RafaelDiasCampos/RoboticChess/Report/TCC II/Project.tex

%% Baseado no arquivo: 
%% abtex2-modelo-trabalho-academico.tex, v-1.9.6 laurocesar
%% by abnTeX2 group at http://www.abntex.net.br/ 
%% Adaptado para um modelo dssse TCC (Graduação)

% ------------------------------------------------------------------------
% ------------------------------------------------------------------------
% abnTeX2: Modelo de Trabalho Academico (tese de doutorado, dissertacao de
% mestrado e trabalhos monograficos em geral) em conformidade com 
% ABNT NBR 14724:2011: Informacao e documentacao - Trabalhos academicos -
% Apresentacao
% ------------------------------------------------------------------------
% ------------------------------------------------------------------------

\documentclass[
	% -- opções da classe memoir --
	12pt,				% tamanho da fonte
	openright,			% capítulos começam em pág ímpar (insere página vazia caso preciso)
	oneside,			% para impressão em recto e verso. Oposto a oneside
	a4paper,			% tamanho do papel. 
	% -- opções da classe abntex2 --
	%chapter=TITLE,		% títulos de capítulos convertidos em letras maiúsculas
	%section=TITLE,		% títulos de seções convertidos em letras maiúsculas
	%subsection=TITLE,	% títulos de subseções convertidos em letras maiúsculas
	%subsubsection=TITLE,% títulos de subsubseções convertidos em letras maiúsculas
	% -- opções do pacote babel --
	english,			% idioma adicional para hifenização
	%french,				% idioma adicional para hifenização
	%spanish,			% idioma adicional para hifenização
	brazil				% o último idioma é o principal do documento
	]{abntex2}

% ---
% Pacotes básicos 
% ---
\usepackage{lmodern}			% Usa a fonte Latin Modern			
\usepackage[T1]{fontenc}		% Selecao de codigos de fonte.
\usepackage[utf8]{inputenc}		% Codificacao do documento (conversão automática dos acentos)
\usepackage{lastpage}			% Usado pela Ficha catalográfica
\usepackage{indentfirst}		% Indenta o primeiro parágrafo de cada seção.
\usepackage{color}				% Controle das cores
\usepackage{graphicx}			% Inclusão de gráficos
\usepackage{microtype} 			% para melhorias de justificação
\usepackage{float}				% para controle de posicionamento de figuras e tabelas
\usepackage{pdfpages} 			% para inclusão de PDFs
\usepackage{breqn}              % para quebrar equações
% ---

% ---
% Pacotes de citações
% ---
\usepackage[brazilian,hyperpageref]{backref}	 % Paginas com as citações na bibl
\usepackage[alf, bibjustif]{abntex2cite}	% Citações padrão ABNT

% --- 
% CONFIGURAÇÕES DE PACOTES
% --- 

% ---
% Configurações do pacote backref
% Usado sem a opção hyperpageref de backref
\renewcommand{\backrefpagesname}{%Citado na(s) página(s):~
}
% Texto padrão antes do número das páginas
\renewcommand{\backref}{}
% Define os textos da citação
\renewcommand*{\backrefalt}[4]{
	%\ifcase #1 %
	%	Nenhuma citação no texto.%
	%\or
	%	Citado na página #2.%
	%\else
	%	Citado #1 vezes nas páginas #2.%
	%\fi
    }%
% ---

% ---
% Informações de dados para CAPA e FOLHA DE ROSTO
% ---
\titulo{Jogo de Xadrez com Manipuladores Robóticos}
\autor{Rafael Dias Campos}
\local{Belo Horizonte}
\data{2023}
\orientador{Ramon da Cunha Lopes}
\instituicao{%
  Centro Federal de Educação Tecnológica de Minas Gerais -- CEFET-MG
  \par
  Departamento de Computação
  \par
  Curso de Engenharia da Computação
  }
\tipotrabalho{Monografia (Graduação)}
% O preambulo deve conter o tipo do trabalho, o objetivo, 
% o nome da instituição e a área de concentração 
\preambulo{Trabalho de Conclusão de Curso apresentado ao Curso
de Engenharia de Computação do Centro Federal de
Educação Tecnológica de Minas Gerais, como requisito
parcial para a obtenção do título de Bacharel em
Engenharia de Computação.}
% ---

% ---
% Configurações de aparência do PDF final

% alterando o aspecto da cor azul
\definecolor{blue}{RGB}{41,5,195}

% informações do PDF
\makeatletter
\hypersetup{
     	%pagebackref=true,
		pdftitle={\@title}, 
		pdfauthor={\@author},
    	pdfsubject={\imprimirpreambulo},
	    pdfcreator={LaTeX with abnTeX2},
		pdfkeywords={abnt}{latex}{abntex}{abntex2}{trabalho acadêmico}, 
		colorlinks=true,       		% false: boxed links; true: colored links
		% hidelinks=true,
    	linkcolor=blue,          	% color of internal links
    	citecolor=blue,        		% color of links to bibliography
    	filecolor=magenta,      		% color of file links
		urlcolor=blue,
		bookmarksdepth=4
}
\makeatother
% --- 

% --- 
% Espaçamentos entre linhas e parágrafos 
% --- 

% O tamanho do parágrafo é dado por:
\setlength{\parindent}{1.3cm}

% Controle do espaçamento entre um parágrafo e outro:
\setlength{\parskip}{0.2cm}  % tente também \onelineskip

% ---
% compila o indice
% ---
\makeindex
% ---

% ----
% Início do documento
% ----
\begin{document}

% Seleciona o idioma do documento (conforme pacotes do babel)
%\selectlanguage{english}
%\selectlanguage{brazil}

% Retira espaço extra obsoleto entre as frases.
\frenchspacing 

% ----------------------------------------------------------
% ELEMENTOS PRÉ-TEXTUAIS
% ----------------------------------------------------------

\include{src/0_pre_textuais}

% ----------------------------------------------------------
% ELEMENTOS TEXTUAIS
% ----------------------------------------------------------
\textual

% ----------------------------------------------------------
% Como o documento será grande, sugiro dividir em diversos arquivos, um para cada capítulo.
% ----------------------------------------------------------

\include{src/1_introducao}

\include{src/2_trabalhos_relacionados}

\include{src/3_metodologia}

\include{src/4_planejamento}

\include{src/5_desenvolvimento}

\include{src/6_conclusao}

% ----------------------------------------------------------

% ----------------------------------------------------------
% Finaliza a parte no bookmark do PDF
% para que se inicie o bookmark na raiz
% e adiciona espaço de parte no Sumário
% ----------------------------------------------------------
\phantompart

% ----------------------------------------------------------
% ELEMENTOS PÓS-TEXTUAIS
% ----------------------------------------------------------

\include{src/pos_textuais.tex}

\end{document}
