RafaelDiasCampos/RoboticChess/Report/TCC I/src/0_pre_textuais.tex

%% Baseado no arquivo: 
%% abtex2-modelo-trabalho-academico.tex, v-1.9.6 laurocesar
%% by abnTeX2 group at http://www.abntex.net.br/ 
%% Adaptado para um modelo de TCC (Graduação)

% ---
% Capa
% ---
\imprimircapa
% ---

% ---
% Folha de rosto
% (o * indica que haverá a ficha bibliográfica)
% ---
\imprimirfolhaderosto*
% ---

% ---
% Inserir a ficha bibliografica
% ---

% Isto é um exemplo de Ficha Catalográfica, ou ``Dados internacionais de
% catalogação-na-publicação''. Você pode utilizar este modelo como referência. 
% Porém, provavelmente a biblioteca da sua universidade lhe fornecerá um PDF
% com a ficha catalográfica definitiva após a defesa do trabalho. Quando estiver
% com o documento, salve-o como PDF no diretório do seu projeto e substitua todo
% o conteúdo de implementação deste arquivo pelo comando abaixo:
%
% \begin{fichacatalografica}
%     
% \end{fichacatalografica}

\begin{fichacatalografica}
~
%\includepdf{fig_ficha_catalografica.pdf}
% 	\sffamily
% 	\vspace*{\fill}					% Posição vertical
% 	\begin{center}					% Minipage Centralizado
% 	\fbox{\begin{minipage}[c][8cm]{13.5cm}		% Largura
% 	\small
% 	\imprimirautor
% 	%Sobrenome, Nome do autor
	
% 	\hspace{0.5cm} \imprimirtitulo  / \imprimirautor. --
% 	\imprimirlocal, \imprimirdata-
	
% 	\hspace{0.5cm} \pageref{LastPage} p. : il. (algumas color.) ; 30 cm.\\
	
% 	\hspace{0.5cm} \imprimirorientadorRotulo~\imprimirorientador\\
	
% 	\hspace{0.5cm}
% 	\parbox[t]{\textwidth}{\imprimirtipotrabalho~--~\imprimirinstituicao,
% 	\imprimirdata.}\\
	
% 	\hspace{0.5cm}
% 		1. Palavra-chave1.
% 		2. Palavra-chave2.
% 		2. Palavra-chave3.
% 		I. Orientador.
% 		II. Universidade xxx.
% 		III. Faculdade de xxx.
% 		IV. Título 			
% 	\end{minipage}}
% 	\end{center}
\end{fichacatalografica}
% ---

% % ---
% % Inserir errata
% % ---
% \begin{errata}
% Elemento opcional da \citeonline[4.2.1.2]{NBR14724:2011}. Exemplo:

% \vspace{\onelineskip}

% FERRIGNO, C. R. A. \textbf{Tratamento de neoplasias ósseas apendiculares com
% reimplantação de enxerto ósseo autólogo autoclavado associado ao plasma
% rico em plaquetas}: estudo crítico na cirurgia de preservação de membro em
% cães. 2011. 128 f. Tese (Livre-Docência) - Faculdade de Medicina Veterinária e
% Zootecnia, Universidade de São Paulo, São Paulo, 2011.

% \begin{table}[htb]
% \center
% \footnotesize
% \begin{tabular}{|p{1.4cm}|p{1cm}|p{3cm}|p{3cm}|}
%   \hline
%    \textbf{Folha} & \textbf{Linha}  & \textbf{Onde se lê}  & \textbf{Leia-se}  \\
%     \hline
%     1 & 10 & auto-conclavo & autoconclavo\\
%    \hline
% \end{tabular}
% \end{table}

% \end{errata}
% ---

% ---
% Inserir folha de aprovação
% ---

%
% \begin{folhadeaprovacao}

%   \begin{center}
%     Espaço destinado à folha de aprovação
% %após aprovação, insira a cópia da folha de aprovação por meio do comando:
% % \includepdf{folhadeaprovacao_final.pdf}
%   \end{center}
  
% \end{folhadeaprovacao}
% ---

% ---
% Dedicatória
% ---
% \begin{dedicatoria}
%    \vspace*{\fill}
%    \centering
%    \noindent
%    \textit{Dedico este trabalho aos alunos(as) do CEFET-MG.} \vspace*{\fill}
% \end{dedicatoria}
% ---

% ---
% Agradecimentos
% ---
% \begin{agradecimentos}
% Agradeço ao Latex e às pessoas que contribuiram com o desenvolvimento do Abntex2 por facilitarem a vida dos graduandos.
% \end{agradecimentos}
% ---

% ---
% Epígrafe
% ---
% \begin{epigrafe}
%     \vspace*{\fill}
% 	\begin{flushright}
% 		\textit{``As pessoas costumam dizer que a motivação não dura sempre. Bem, nem o efeito do banho, por isso recomenda-se diariamente.''\\
% 		(Zig Ziglar)}
% 	\end{flushright}
% \end{epigrafe}
% ---

% ---
% RESUMOS
% ---

% resumo em português
\setlength{\absparsep}{18pt} % ajusta o espaçamento dos parágrafos do resumo
\begin{resumo}
  Atualmente, existe uma grande procura por funcionários especializados em Tecnologia da Informação (TI) e áreas similares, sendo percebida no mundo todo uma carência de profissionais qualificados para atuar nessas áreas.
  Esse problema ocorre parcialmente devido a um desinteresse à capacitação técnica por parte de crianças e jovens, frequentemente devido a uma concepção de que essas áreas são difíceis e/ou desinteressantes.
  Com o foco neste aspecto, esse projeto visa desenvolver um sistema que possibilita o jogo de Xadrez entre duas pessoas por meio de manipuladores robóticos.
  Este sistema pode ser apresentado para crianças e jovens em feiras educativas e eventos similares com o objetivo de introduzir conceitos básicos e instigar o interesse pelas áreas de computação, elétrica e controle.
  Sistemas já existentes para mover peças de xadrez com braços mecânicos normalmente são utilizados para que uma máquina jogue contra um jogador humano em campeonatos e com isso apresentam alto custo monetário, visto que priorizam velocidade e precisão nos movimentos.
  Por isso, eles não são muito adequados para usos educacionais e têm-se a necessidade de desenvolver um sistema mais barato e com foco na simplicidade e na capacidade de proporcionar divertimento para os jogadores.
  Nesse projeto serão utilizados manipuladores robóticos comerciais já adquiridos pela instituição de ensino.
  Para o controle dos manipuladores, serão utilizados dois \textit{joysticks}, um para cada jogador, que enviam sinais para uma placa de controle dos manipuladores por meio de um microcontrolador.
  Até o momento, foi desenvolvida uma placa de controle para enviar os sinais para os manipuladores robóticos, e um \textit{software} para realizar a leitura dos \textit{joysticks} e enviar os sinais para a placa de controle.
  Ainda está em desenvolvimento o \textit{software} que implementará a lógica do jogo de Xadrez, e o controle do segundo manipulador.
 \textbf{Palavras-chave}: Manipuladores Robóticos. Controle Digital. Xadrez.
\end{resumo}

% resumo em inglês
\begin{resumo}[Abstract]
 \begin{otherlanguage*}{english}
  Currently, there is a great demand for specialized professionals in IT and in similar areas, and it is perceived worldwide a shortage of qualified professionals to work in these areas.
  This problem occurs partially due to a lack of technical training on the part of children and young people, often due to a conception that these areas are difficult and / or uninteresting.
  Focusing on this aspect, this project aims to develop a system that allows the game of Chess between two people through robotic manipulators.
  This system can be presented to children and young people in educational fairs and similar events with the aim of introducing basic concepts and instigating interest in the areas of computing, electrical and control.
  Systems already exist to move chess pieces with mechanical arms usually used to allow a machine to play against a human player in tournaments and with that they present high monetary cost, for they prioritize speed and precision in movements.
  Therefore, they are not very suitable for educational uses and there is a need to develop a cheaper system and with a focus on simplicity and the ability to provide fun for players.
  In this project will be used commercial robotic manipulators already acquired by the educational institution.
  For the control of the manipulators, two joysticks will be used, one for each player, which send signals to a control board through a microcontroller.
  So far, a control board has been developed to send signals to the robotic manipulators and a software to read the joysticks and send signals to the control board.
  The software that implements the logic of the Chess game is still under development, as well as the control of the second manipulator.

   \vspace{\onelineskip}
 
   \noindent 
   \textbf{Keywords}: Robotic Arms. Digital Control. Chess.
 \end{otherlanguage*}
\end{resumo}

% ---

% ---
% inserir lista de ilustrações
% ---
\pdfbookmark[0]{\listfigurename}{lof}
\listoffigures*
\cleardoublepage
% ---

% ---
% inserir lista de tabelas
% ---
\pdfbookmark[0]{\listtablename}{lot}
\listoftables*
\cleardoublepage
% ---

% ---
% inserir lista de abreviaturas e siglas
% ---
\begin{siglas}
  \item[CI] Circuito Integrado
  \item[CEFET-MG] Centro Federal de Educação Tecnológica de Minas Gerais
  \item[STEM] \textit{Science, Technology, Engineering and Mathematics} [Ciência, Tecnologia, Engenharia e Matemática]
  \item[PID] \textit{Proportional Integral Derivative} [Proporcional Integral Derivativo]
  \item[PWM] \textit{Pulse Width Modulation} [Modulação de Largura de Pulso]  
\end{siglas}
% ---

% ---
% inserir lista de símbolos
% ---
% \begin{simbolos}
%   \item[$ \Gamma $] Letra grega Gama
%   \item[$ \Lambda $] Lambda
%   \item[$ \zeta $] Letra grega minúscula zeta
%   \item[$ \in $] Pertence
% \end{simbolos}
% ---

% ---
% inserir o sumario
% ---
\pdfbookmark[0]{\contentsname}{toc}
\tableofcontents*
\cleardoublepage
% ---
