RafaelDiasCampos/RoboticChess/Report/PreProject/src/pos_textuais_preproject.tex

%% Baseado no arquivo: 
%% abtex2-modelo-trabalho-academico.tex, v-1.9.6 laurocesar
%% by abnTeX2 group at http://www.abntex.net.br/ 
%% Adaptado para um modelo de TCC (Graduação)

\postextual
% ----------------------------------------------------------

% ----------------------------------------------------------
% Referências bibliográficas
% ----------------------------------------------------------
\bibliography{report}

% ----------------------------------------------------------
% Glossário
% ----------------------------------------------------------
%
% Consulte o manual da classe abntex2 para orientações sobre o glossário.
%
%\glossary
