RafaelDiasCampos/RoboticChess/Report/PreProject/src/2_metodologia.tex

\chapter[Metodologia]{Metodologia}
\label{cap:metodologia}

Para o desenvolvimento desse projeto, foi realizada a seguinte divisão em atividades:

\begin{itemize}
    \item \textbf{Análise do problema:} Análise do problema e definição de objetivos.
    \item \textbf{Pesquisa bibliográfica:} Pesquisa bibliográfica para a definição de tecnologias a serem utilizadas.
    \item \textbf{Projeto do sistema:} Projeto do sistema de controle de manipuladores robóticos e de microcontroladores utilizados.
    \item \textbf{Controle de um manipulador:} Controle de um manipulador robótico para realização de partidas de Xadrez entre um jogador humano e o computador.
    \item \textbf{Controle de dois manipuladores:} Controle de dois manipuladores robóticos para realização de partidas de Xadrez entre dois jogadores humanos.
    \item \textbf{Avaliação:} Avaliação do protótipo quanto a funcionalidade e ao cumprimento dos objetivos propostos.
\end{itemize}
