RafaelDiasCampos/RoboticChess/Report/PreProject/src/3_infraestrutura_necessaria.tex

\chapter[Infraestrutura Necessária]{Infraestrutura Necessária}
\label{cap:infraestrutura_necessaria}

Para o desenvolvimento desse projeto, foi definida a necessidade dos seguintes recursos:

\begin{itemize}
    \item \textbf{Manipuladores robóticos:} Capazes de realizar movimentos de rotação e translação, além de serem capazes de realizar movimentos de pinça para a captura de peças.
    \item \textbf{Placas de controle}: Necessárias para realizar o controle dos manipuladores robóticos por meio de microcontroladores.
    \item \textbf{Microcontroladores:} Utilizados para a comunicação com os manipuladores robóticos e com o computador.
    \item \textbf{Computador:} Realiza a comunicação com os microcontroladores.
    \item \textbf{Jogo de Xadrez:} Necessário para a realização de partidas de Xadrez.
\end{itemize}
