RafaelDiasCampos/RoboticChess/Report/TCC I/img/foto-arduino.png

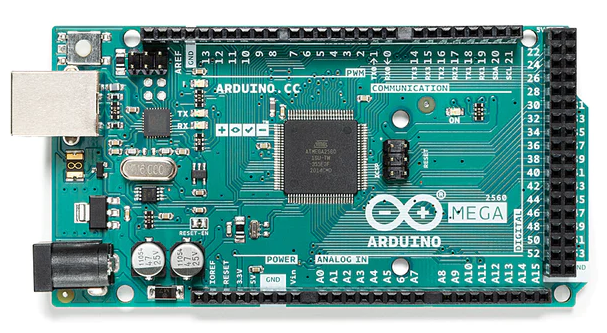
Report/TCC I/img/foto-arduino.png
