RafaelDiasCampos/RoboticChess/Report/TCC I/img/placa-controle-esquematico-simplificado.png

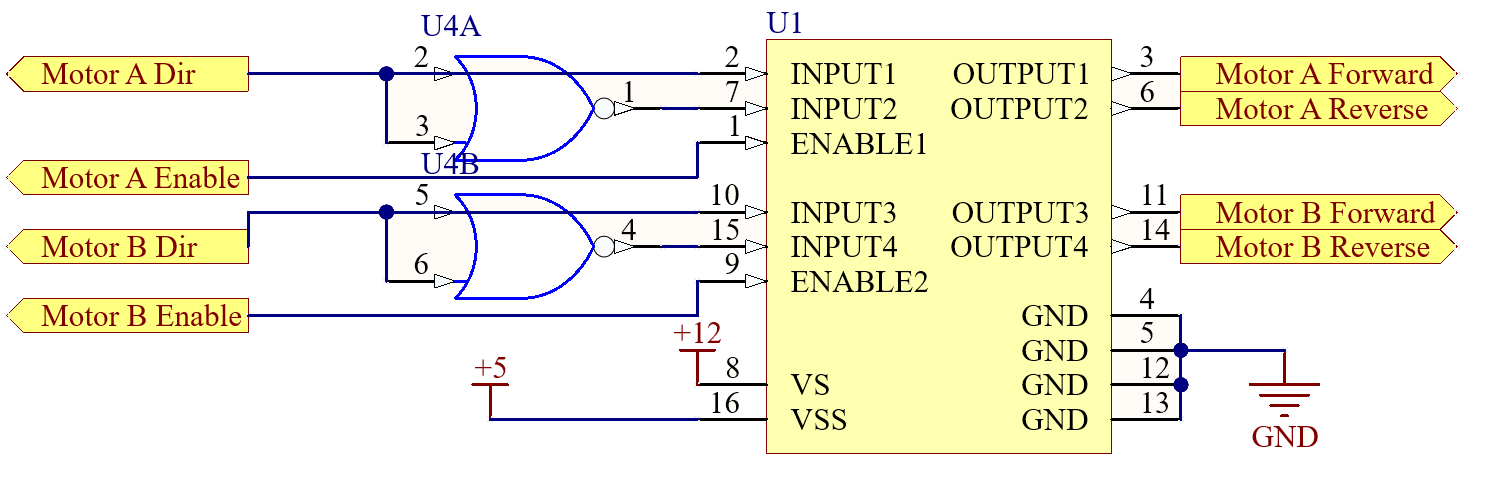
Report/TCC I/img/placa-controle-esquematico-simplificado.png
