RafaelDiasCampos/RoboticChess/Report/TCC I/img/placa-controle-layout.png

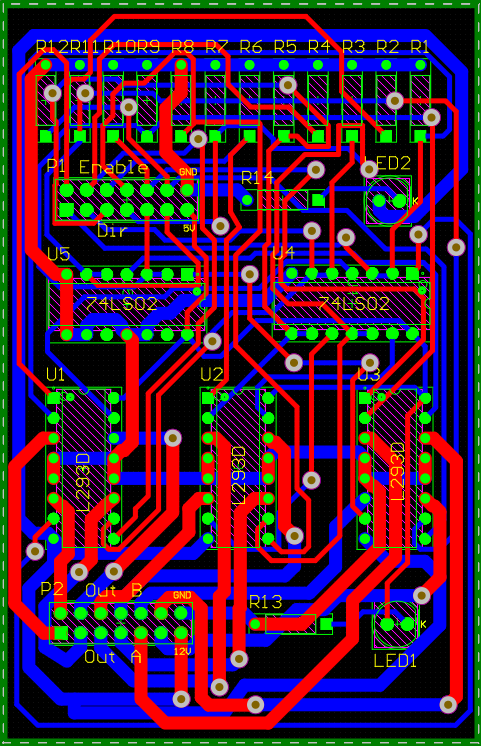
Report/TCC I/img/placa-controle-layout.png
