RafaelDiasCampos/RoboticChess/Report/TCC I/img/projeto-sistema.png

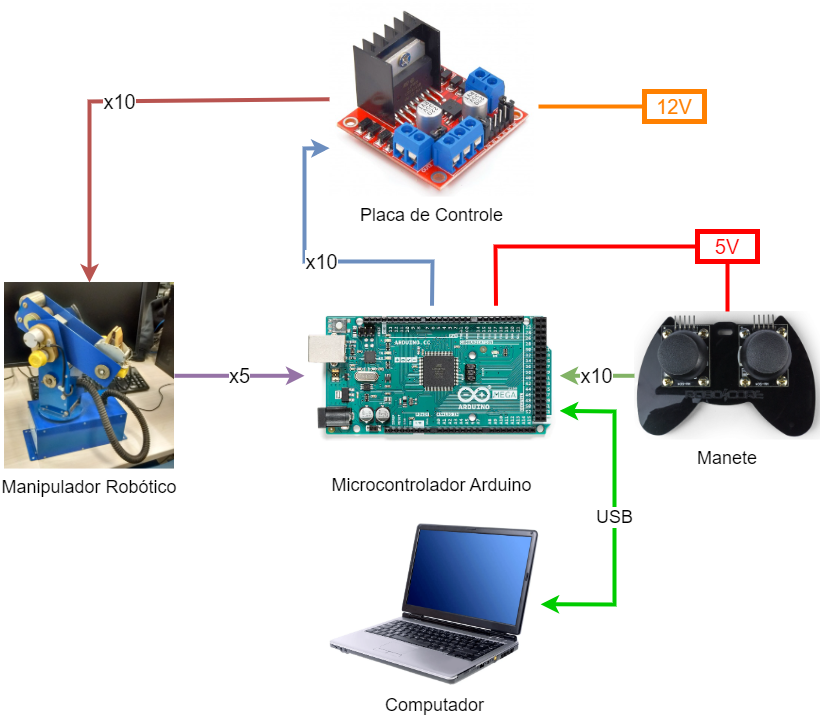
Report/TCC I/img/projeto-sistema.png
