RafaelDiasCampos/RoboticChess/Report/TCC II/img/Cálculo ângulo pulso.png

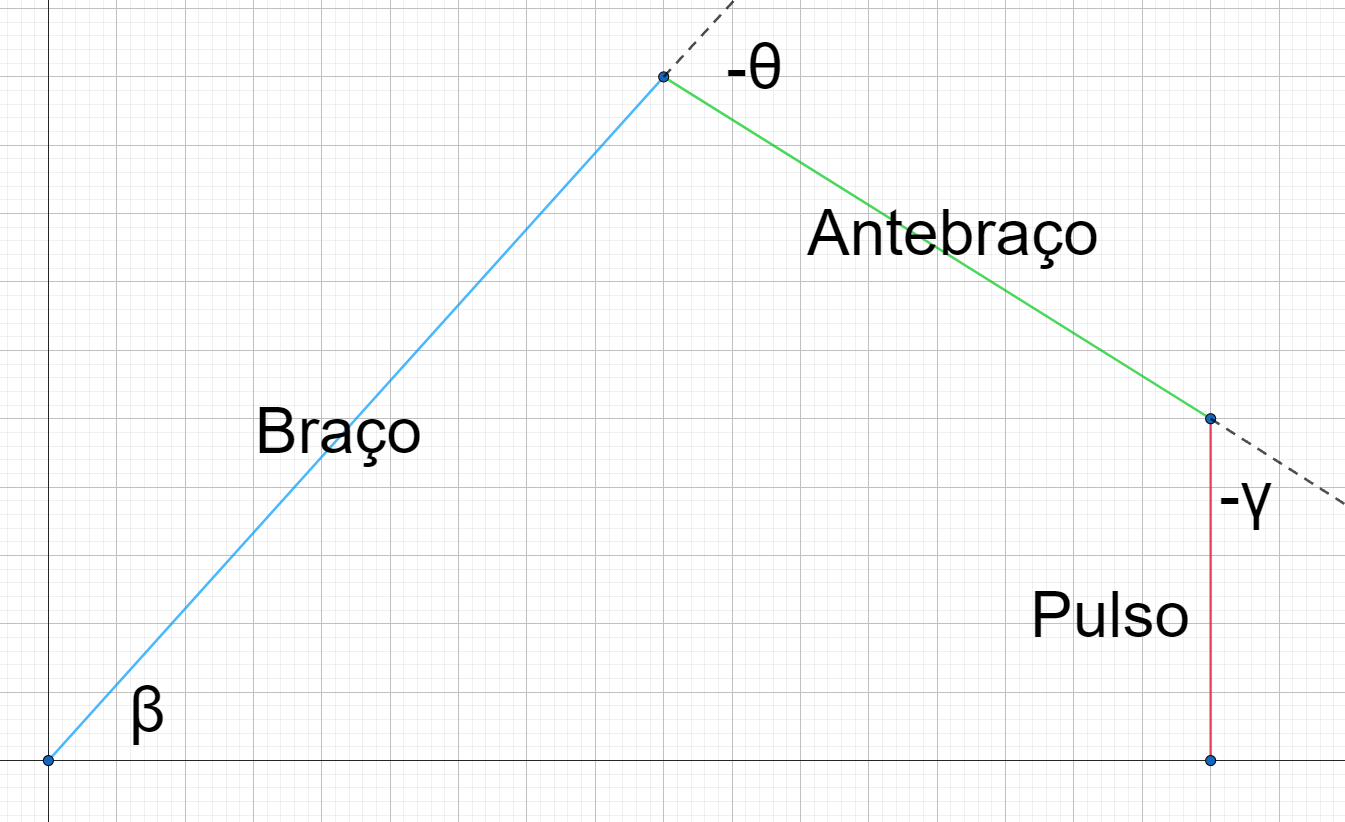
Report/TCC II/img/Cálculo ângulo pulso.png
