RafaelDiasCampos/RoboticChess/Report/TCC II/img/leitura-juntas.png

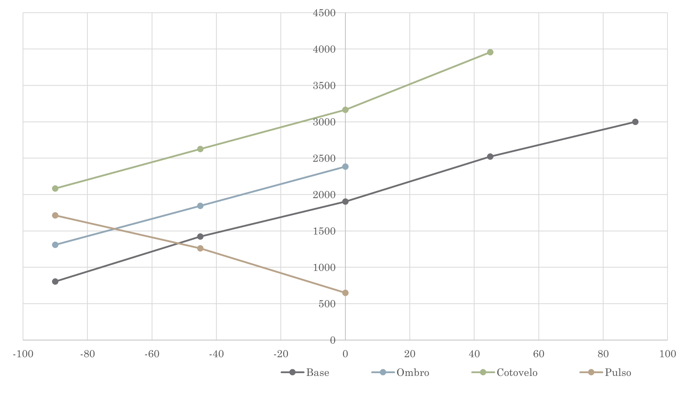
Report/TCC II/img/leitura-juntas.png
