RafaelDiasCampos/RoboticChess/Report/TCC II/img/levando-peca.png

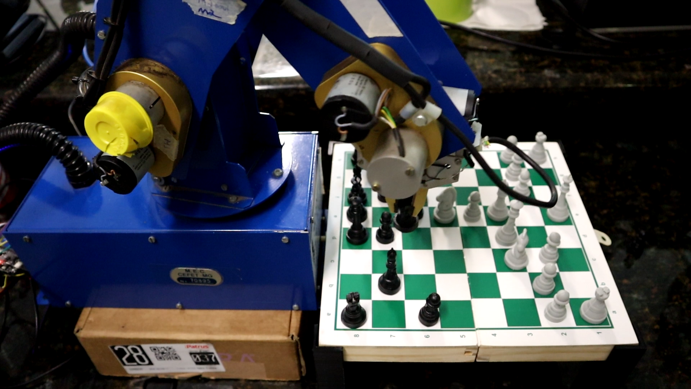
Report/TCC II/img/levando-peca.png
