RafaelDiasCampos/RoboticChess/Report/TCC II/img/pegando-peca.png

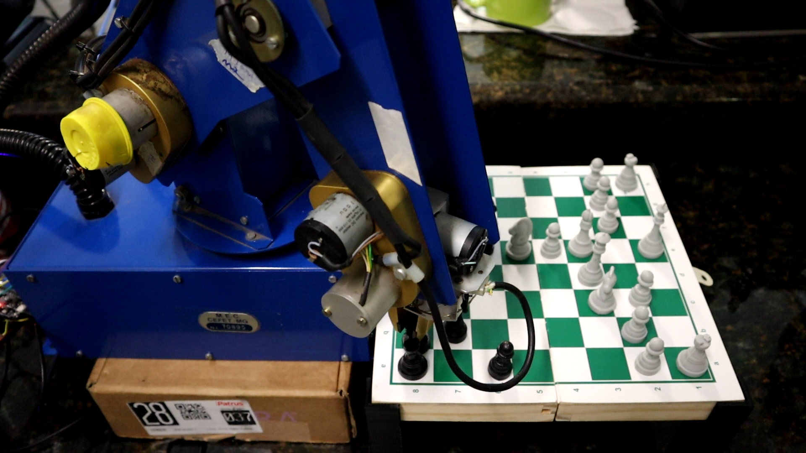
Report/TCC II/img/pegando-peca.png
