RafaelDiasCampos/RoboticChess/Report/TCC II/img/retornando-repouso.png

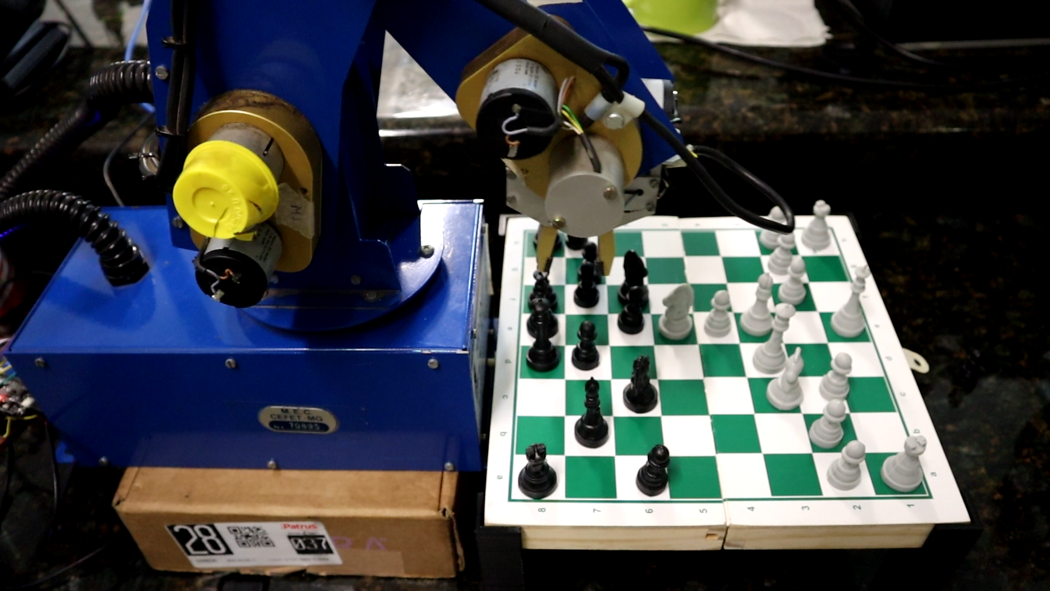
Report/TCC II/img/retornando-repouso.png
