RafaelDiasCampos/RoboticChess/Report/TCC II/img/software-tabuleiro.png

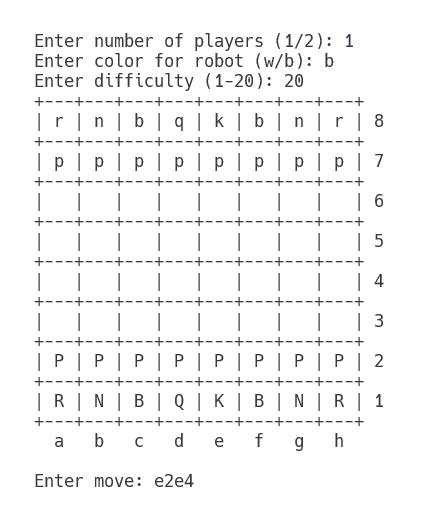
Report/TCC II/img/software-tabuleiro.png
