RafaelDiasCampos/RoboticChess/Report/TCC II/img/soltando-peca.png

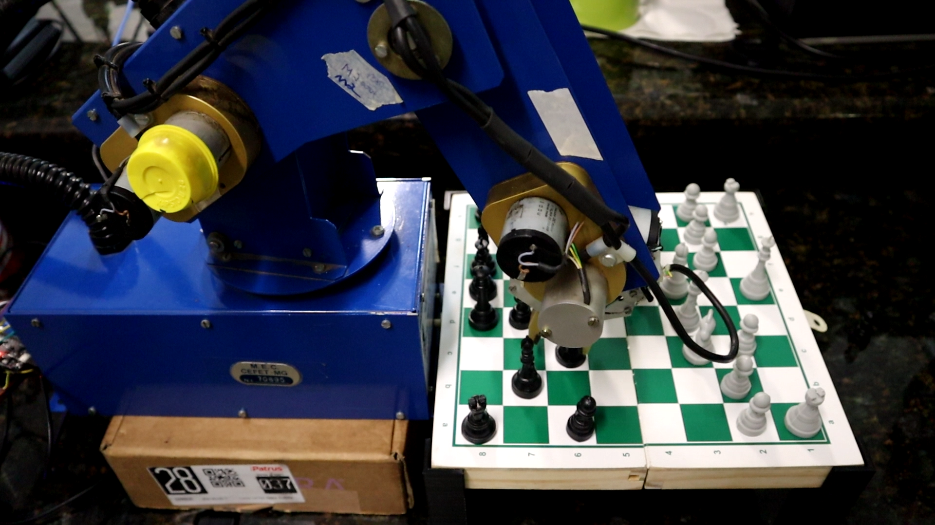
Report/TCC II/img/soltando-peca.png
