RafaelDiasCampos/RoboticChess/Report/TCC II/img/xadrez-pecas.png

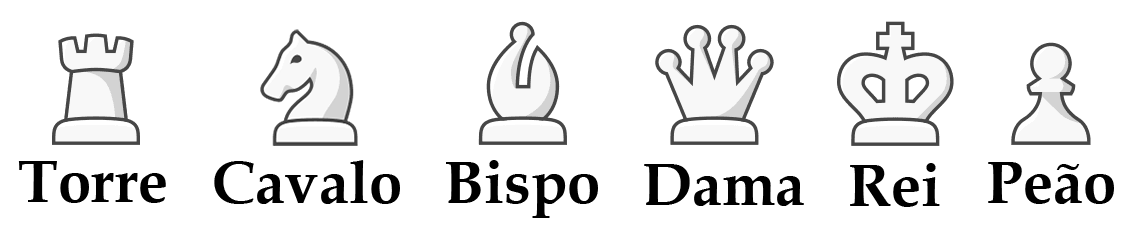
Report/TCC II/img/xadrez-pecas.png
