RafaelDiasCampos/RoboticChess/Report/TCC II/img/Ângulo base.png

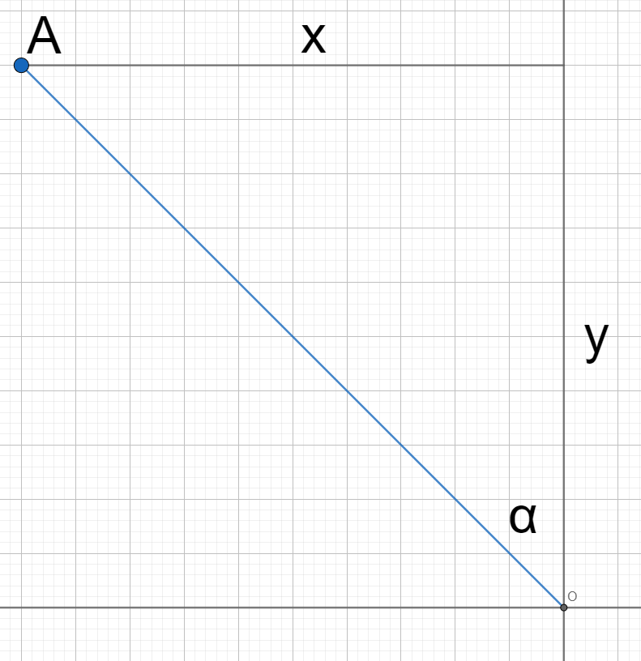
Report/TCC II/img/Ângulo base.png
