RafaelDiasCampos/RoboticChess/Report/TCC I/anexos/Placa-Controle-Esquemático.pdf

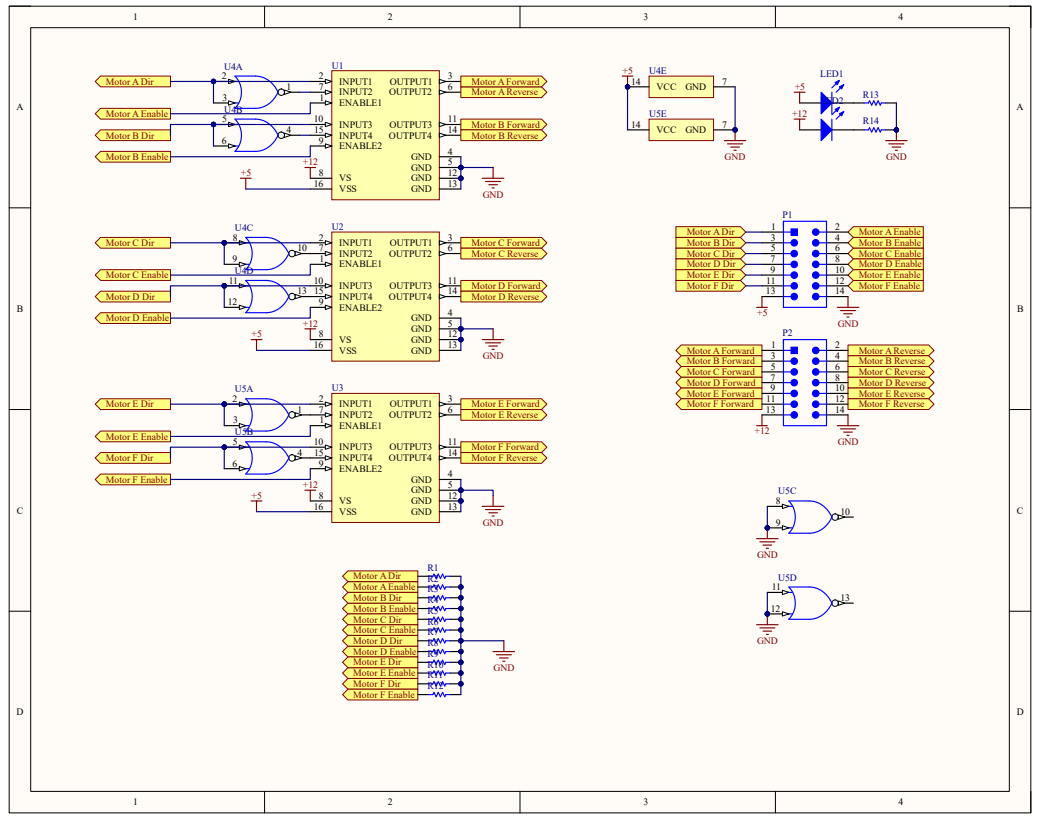
[picture p45: page 1]
