RafaelDiasCampos/RoboticChess/(list of files, drawings)

Other design files:
design/PCB2.PcbDoc
design/Placa controle manipuladores robóticos.PrjPcb
design/Schematic.SchDoc
