RafaelDiasCampos/RoboticChess/(commit log)

2022-11-07 Added Arduino code
    [Configuration.h]
2022-11-14 Improved PID control
    [Configuration.h]
2022-12-05 Improved Report. Added manual robotic arm control.
    [Configuration.h]
2023-06-30 Added TCCII
    [Configuration.h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]
2023-07-07 Fixed commented line in software
    [roboticChess.py]
